MTD2A/Train_Emergency_Stop/image/Massoth-8170001-Dimax-Feedback-module.png

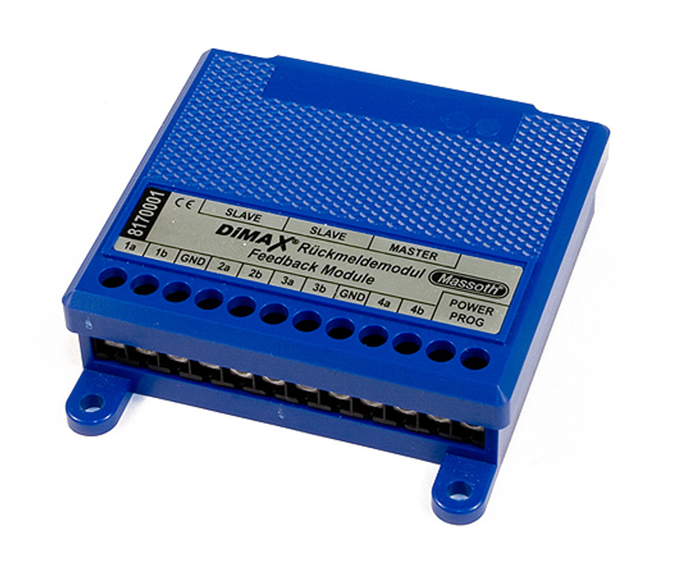
image/Massoth-8170001-Dimax-Feedback-module.png
