MTD2A/Train_Emergency_Stop/image/Massoth-8170010-Dimax-FB-Feedback-module.jpg

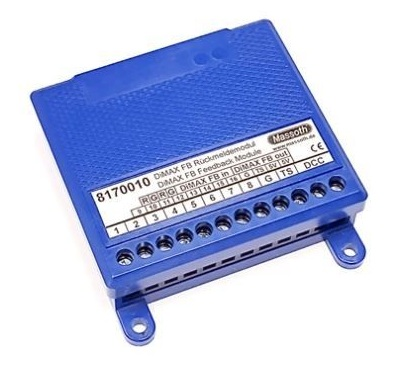
image/Massoth-8170010-Dimax-FB-Feedback-module.jpg
