MTD2A/Train_Emergency_Stop/image/massoth-emotion-xls-sound-decoder.jpg

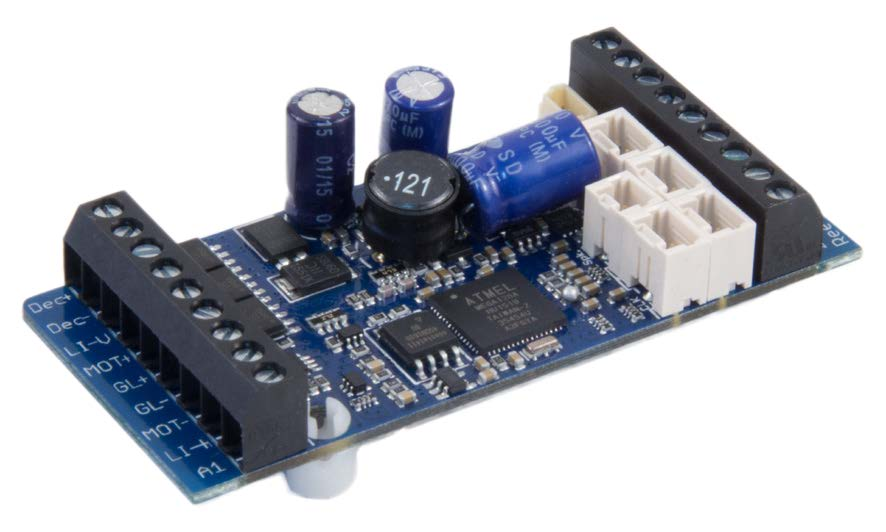
image/massoth-emotion-xls-sound-decoder.jpg
